Bobbo117/MQ135-Air-Quality-Sensor/Images/HA AQI 17K.jpg

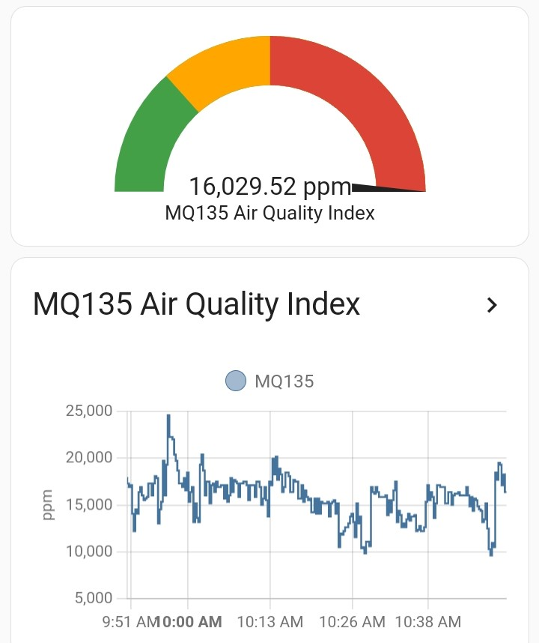
Images/HA AQI 17K.jpg
